DanNixon/ethernet-hexpansion/README.md

# Ethernet Hexpansion

W5500 based Ethernet and PoE hexpansion for the [Tildagon](https://tildagon.badge.emfcamp.org/) badge.

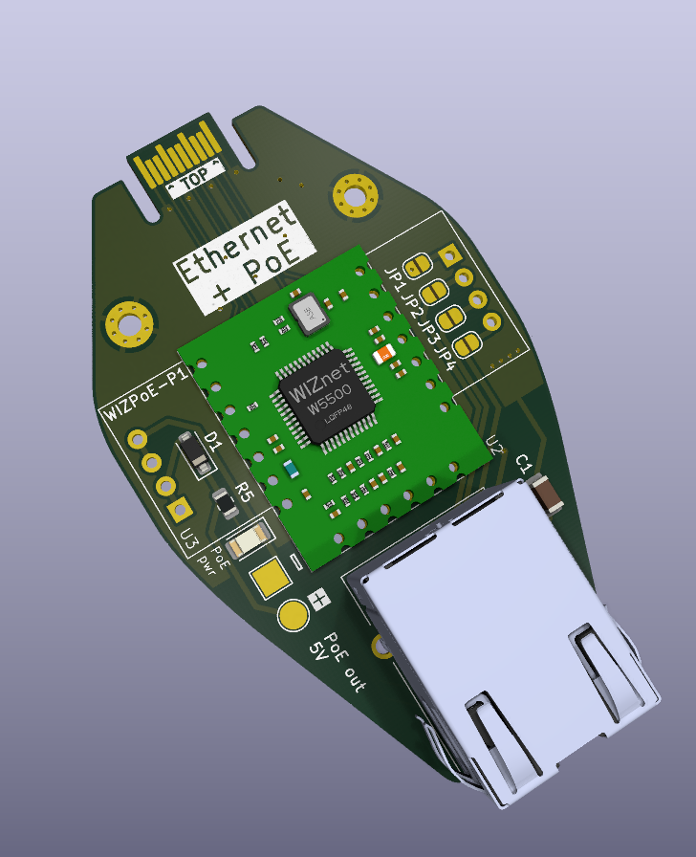
[picture p1: docs/render-front.png]
Render of PCB front
