DanNixon/ethernet-hexpansion/docs/pins.md

# Pinout

|Function|Pin |
|---|----|
|MOSI |HS 3|
|MISO |HS 4|
|SCK |HS 2|
|CS |LS 2|
|Int. |HS 1|
|Reset |LS 1|
