DanNixon/ethernet-hexpansion/docs/render-back.png

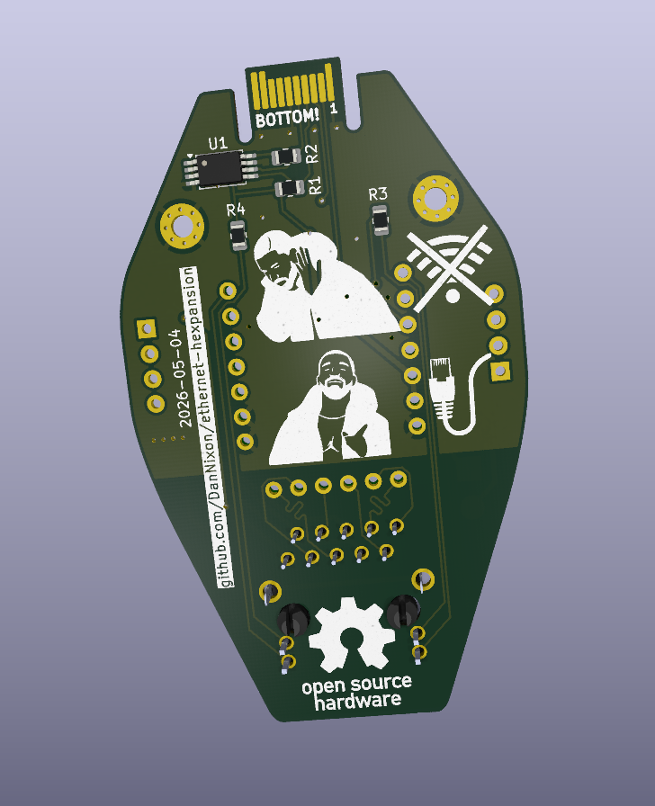
docs/render-back.png
