DanNixon/ethernet-hexpansion/pcb/drake.png

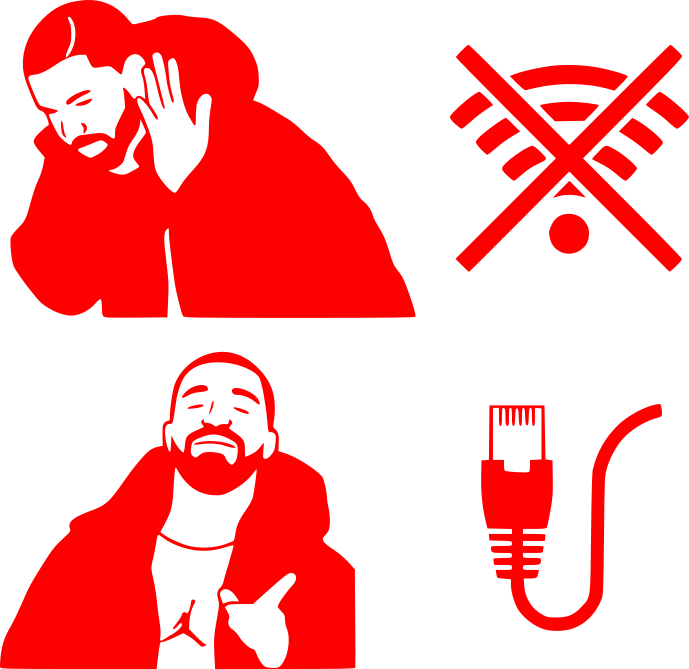
pcb/drake.png
