DanNixon/ethernet-hexpansion/pcb/hexpansion.kicad_pcb

## KiCad design pcb/hexpansion.kicad_pcb (2026-05-15)

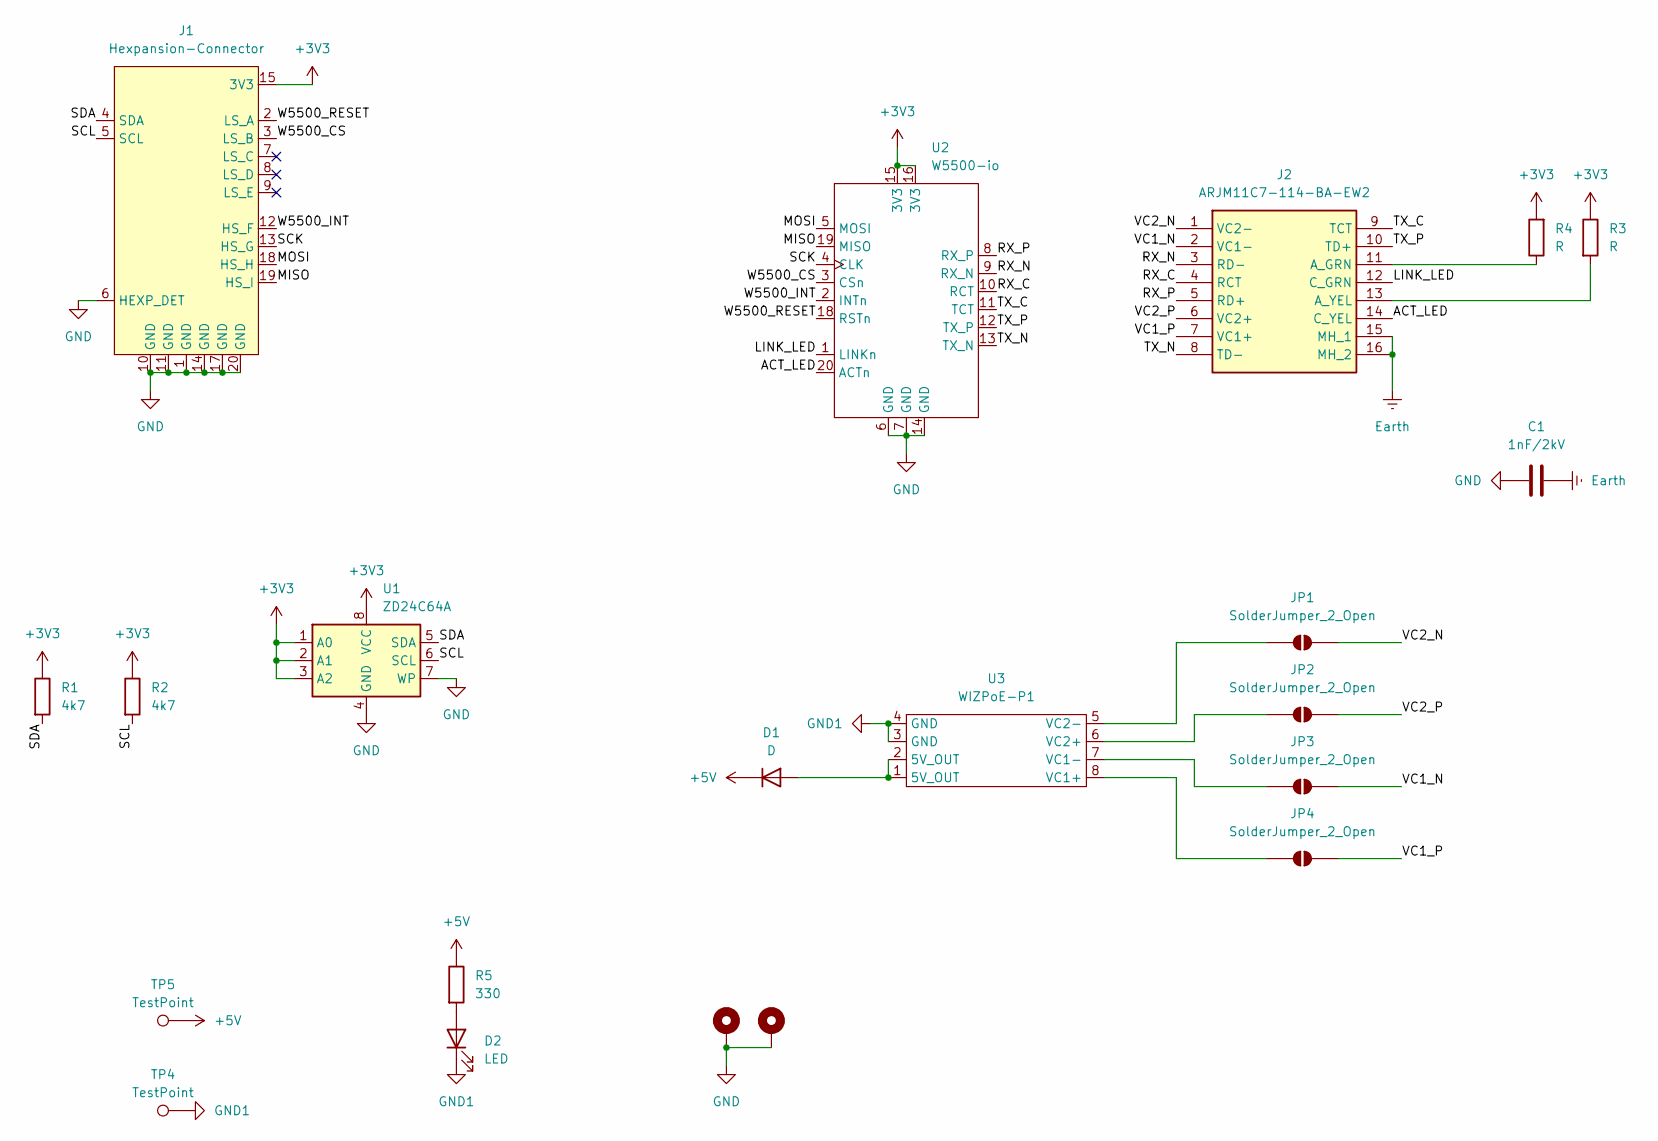
[picture p5: schematic hexpansion.kicad_sch]

Parts:
C1: 1nF/2kV; C_1206_3216Metric
D1: D; D_SOD-123
D2: LED; LED_1206_3216Metric
H1, H2: MountingHole_Pad; MountingHole_2.2mm_M2_Pad_Via
J1: Hexpansion-Connector; hexpansion-edge-connector
J2: ARJM11C7-114-BA-EW2; ARJM11C7114BAEW2; Mouser Part Number 815-RJM11C7114BAEW2
JP1, JP2, JP3, JP4: SolderJumper_2_Open; SolderJumper-2_P1.3mm_Open_RoundedPad1.0x1.5mm
R1, R2: 4k7; R_0805_2012Metric; LCSC C3017854
R3, R4: R; R_0805_2012Metric
R5: 330; R_0805_2012Metric
TP4: TestPoint; TestPoint_Pad_2.5x2.5mm
TP5: TestPoint; TestPoint_Pad_D2.5mm
U1: ZD24C64A; TSSOP-8_4.4x3mm_P0.65mm; LCSC C2875852
U2: W5500-io
U3: WIZPoE-P1

Connections:
+3V3: J1.15 (3V3), J1.16 (3V3), R1.1, R2.1, R3.1, R4.2, U1.1 (A0), U1.2 (A1), U1.3 (A2), U1.8 (VCC), U2.15 (3V3), U2.16 (3V3)
+5V: D1.1 (K), R5.1, TP5.1 (1_1)
/ACT_LED: J2.14 (C_YEL), U2.20 (ACTn)
/LINK_LED: J2.12 (C_GRN), U2.1 (LINKn)
/MISO: J1.19 (HS_I), U2.19 (MISO)
/MOSI: J1.18 (HS_H), U2.5 (MOSI)
/RX_C: J2.4 (RCT), U2.10 (RCT)
/RX_N: J2.3 (RD-), U2.9 (RX_N)
/RX_P: J2.5 (RD+), U2.8 (RX_P)
/SCK: J1.13 (HS_G), U2.4 (CLK)
/SCL: J1.5 (SCL), R2.2, U1.6 (SCL)
/SDA: J1.4 (SDA), R1.2, U1.5 (SDA)
/TX_C: J2.9 (TCT), U2.11 (TCT)
/TX_N: J2.8 (TD-), U2.13 (TX_N)
/TX_P: J2.10 (TD+), U2.12 (TX_P)
/VC1_N: J2.2 (VC1-), JP3.2 (B)
/VC1_P: J2.7 (VC1+), JP4.2 (B)
/VC2_N: J2.1 (VC2-), JP1.2 (B)
/VC2_P: J2.6 (VC2+), JP2.2 (B)
/W5500_CS: J1.3 (LS_B), U2.3 (CSn)
/W5500_INT: J1.12 (HS_F), U2.2 (INTn)
/W5500_RESET: J1.2 (LS_A), U2.18 (RSTn)
Earth: C1.1, J2.15 (MH_1), J2.16 (MH_2)
GND: C1.2, H1.1 (1_1), H2.1 (1_1), J1.1 (GND), J1.6 (HEXP_DET), J1.10 (GND), J1.11 (GND), J1.14 (GND), J1.17 (GND), J1.20 (GND), U1.4 (GND), U1.7 (WP), U2.6 (GND), U2.7 (GND), U2.14 (GND)
GND1: D2.1 (K), TP4.1 (1_1), U3.3 (GND), U3.4 (GND)
unnamed: D1.2 (A), U3.1 (5V_OUT), U3.2 (5V_OUT)
unnamed: D2.2 (A), R5.2
unnamed: J2.11 (A_GRN), R4.1
unnamed: J2.13 (A_YEL), R3.2
unnamed: JP1.1 (A), U3.5 (VC2-)
unnamed: JP2.1 (A), U3.6 (VC2+)
unnamed: JP3.1 (A), U3.7 (VC1-)
unnamed: JP4.1 (A), U3.8 (VC1+)

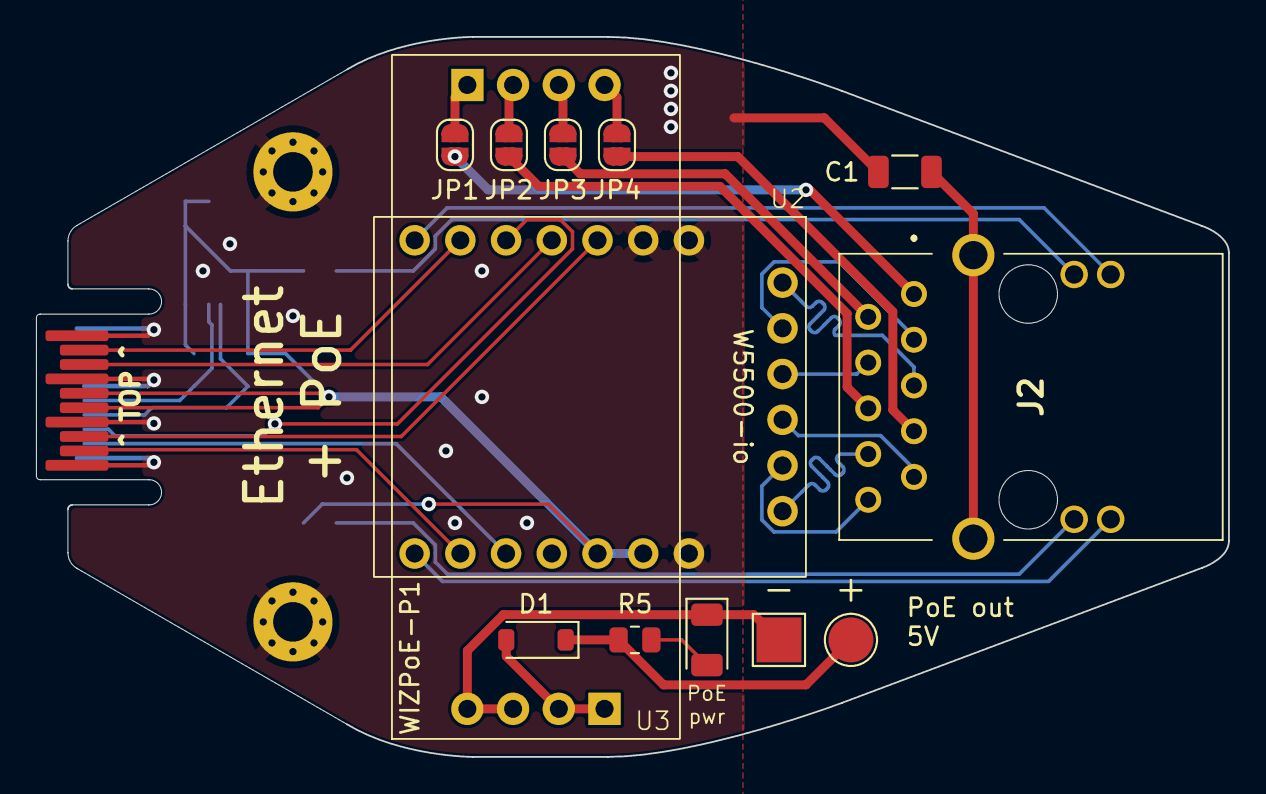
[picture p6: board hexpansion.kicad_pcb from above]

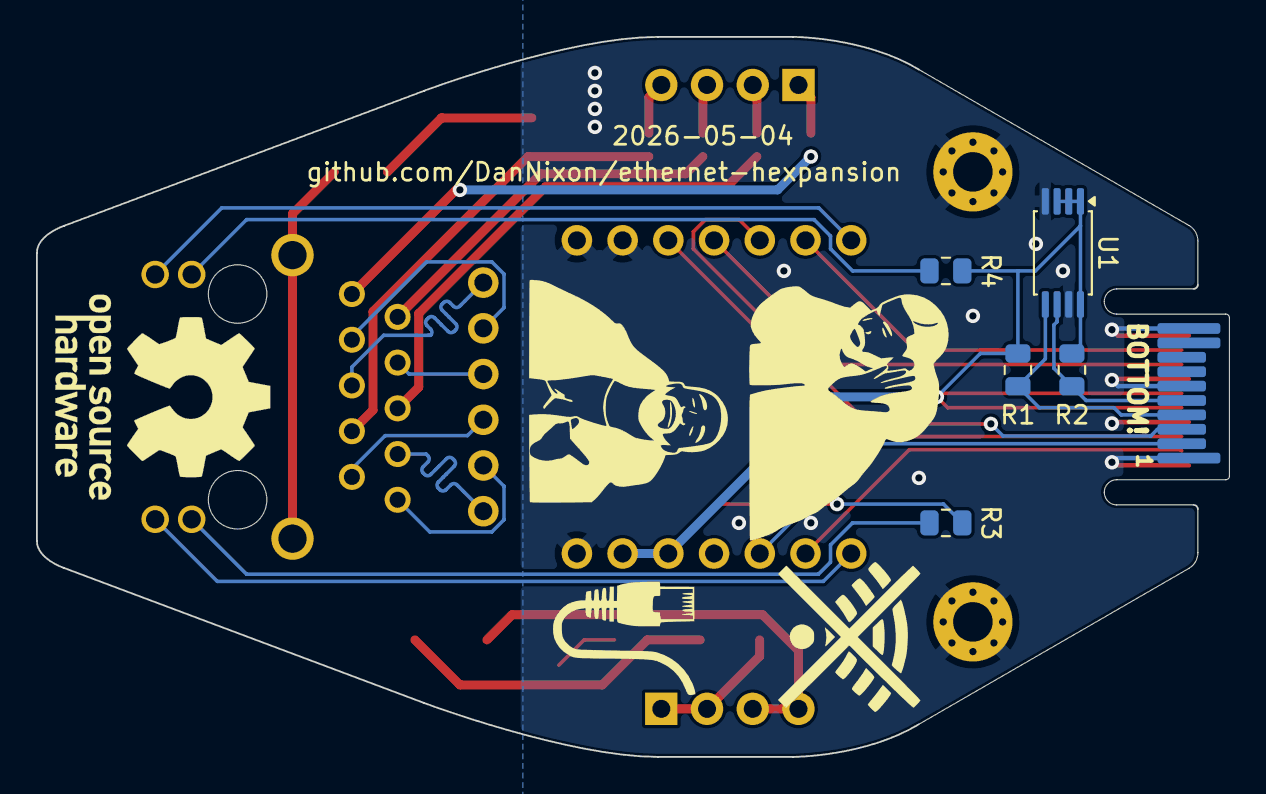
[picture p7: board hexpansion.kicad_pcb from below]

Board: 2 copper layers, 66.2 x 40.0 mm, 21 parts (5 on the bottom side), 33 nets.
