DanNixon/ethernet-hexpansion/demo-firmware/src/main.rs

#![no_std]
#![no_main]
#![deny(
    clippy::mem_forget,
    reason = "mem::forget is generally not safe to do with esp_hal types, especially those \
    holding buffers for the duration of a data transfer."
)]

mod display;
mod fake_pin;
mod leds;
mod wall_time;

use defmt::info;
use embassy_executor::Spawner;
use embassy_net::StackResources;
use embassy_net_wiznet::{Device, Runner, State, chip::W5500};
use embassy_time::Timer;
use embedded_hal_bus::spi::ExclusiveDevice;
use fake_pin::FakePin;
use panic_rtt_target as _;
use static_cell::StaticCell;
use tildagon::{
    embedded_aw9523::{PinConfiguration, async_traits::digital::OutputPin},
    esp_hal::{
        self,
        clock::CpuClock,
        dma::{DmaRxBuf, DmaTxBuf},
        dma_buffers,
        gpio::Input,
        rmt::Rmt,
        rng::Rng,
        spi::{
            Mode,
            master::{Config, Spi, SpiDmaBus},
        },
        time::Rate,
        timer::timg::TimerGroup,
    },
    hexpansions::{HexpansionSlot, HexpansionSlotControl},
    i2c::{SharedI2cBus, SharedI2cDevice, SystemI2cBus},
    led_power::OnboardLedPower,
    pins::PinControl,
    resources::*,
    usb::{UsbPort, UsbSwitch},
};

extern crate alloc;

// This creates a default app-descriptor required by the esp-idf bootloader.
// For more information see: <https://docs.espressif.com/projects/esp-idf/en/stable/esp32/api-reference/system/app_image_format.html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>
esp_bootloader_esp_idf::esp_app_desc!();

#[esp_rtos::main]
async fn main(spawner: Spawner) {
    rtt_target::rtt_init_defmt!();

    let config = tildagon::esp_hal::Config::default().with_cpu_clock(CpuClock::max());
    let p = tildagon::esp_hal::init(config);
    let r = tildagon::split_resources!(p);

    esp_alloc::heap_allocator!(size: 64 * 1024);
    // COEX needs more RAM - so we've added some more
    esp_alloc::heap_allocator!(#[unsafe(link_section = ".dram2_uninit")] size: 64 * 1024);

    let timg0 = TimerGroup::new(p.TIMG0);
    esp_rtos::start(timg0.timer0);

    static I2C_BUS: StaticCell<SharedI2cBus<tildagon::i2c::I2c>> = StaticCell::new();
    let (bus, _reset) = tildagon::i2c::i2c_bus(r.i2c).await;
    let i2c_bus = I2C_BUS.init(bus);

    static I2C_SYSTEM: StaticCell<SharedI2cBus<tildagon::i2c::SystemI2cBus>> = StaticCell::new();
    let i2c_system = I2C_SYSTEM.init(tildagon::i2c::system_i2c_bus(i2c_bus));

    let mut pin_control = PinControl::new(i2c_system).await.unwrap();
    let pins = pin_control.pins();

    let mut usb_sw = UsbSwitch::new(pins.usb);
    usb_sw.set(UsbPort::In).await.unwrap();

    let mut hex_slots = HexpansionSlotControl::new(pins.hexpansion_detect)
        .await
        .unwrap();

    let rmt: Rmt<'_, esp_hal::Blocking> = Rmt::new(p.RMT, Rate::from_mhz(80)).unwrap();

    let mut led_power = OnboardLedPower::new(pins.led);
    led_power.set(true).await.unwrap();

    spawner.must_spawn(leds::task(r.led, rmt.channel0));

    let hex_a_fast = r.hexpansion_a;
    let hex_a_slow = pins.hexpansion_a;

    hex_slots
        .set_enabled(HexpansionSlot::A, true)
        .await
        .unwrap();

    let dma_channel = p.DMA_CH1;

    let (rx_buffer, rx_descriptors, tx_buffer, tx_descriptors) = dma_buffers!(32000);
    let dma_rx_buf = DmaRxBuf::new(rx_descriptors, rx_buffer).unwrap();
    let dma_tx_buf = DmaTxBuf::new(tx_descriptors, tx_buffer).unwrap();

    let cs = hex_a_slow.ls_2.try_into_output().await.unwrap();

    let spi = Spi::new(
        p.SPI3,
        Config::default()
            .with_frequency(Rate::from_mhz(10))
            .with_mode(Mode::_0),
    )
    .unwrap()
    .with_sck(hex_a_fast.hs_2)
    .with_mosi(hex_a_fast.hs_3)
    .with_miso(hex_a_fast.hs_4)
    .with_dma(dma_channel)
    .with_buffers(dma_rx_buf, dma_tx_buf)
    .into_async();

    let w5500_int = Input::new(hex_a_fast.hs_1, Default::default());

    let mut w5500_reset = hex_a_slow.ls_1.try_into_output().await.unwrap();
    w5500_reset.set_low().await.unwrap();
    Timer::after_millis(100).await;
    w5500_reset.set_high().await.unwrap();
    Timer::after_millis(100).await;

    let w5500_spi_dev = ExclusiveDevice::new(spi, cs, embassy_time::Delay).unwrap();

    let mac_addr = [0x02, 0x00, 0x00, 0x00, 0x00, 0x00];
    static STATE: StaticCell<State<8, 8>> = StaticCell::new();
    let state = STATE.init(State::<8, 8>::new());
    let (device, runner) = embassy_net_wiznet::new(
        mac_addr,
        state,
        w5500_spi_dev,
        w5500_int,
        FakePin::default(),
    )
    .await
    .unwrap();
    spawner.spawn(ethernet_task(runner)).unwrap();

    let rng = Rng::new();
    let seed = rng.random() as u64;

    static RESOURCES: StaticCell<StackResources<3>> = StaticCell::new();
    let (stack, runner) = embassy_net::new(
        device,
        embassy_net::Config::dhcpv4(Default::default()),
        RESOURCES.init(StackResources::new()),
        seed,
    );
    spawner.spawn(net_task(runner)).unwrap();

    spawner.must_spawn(display::task(r.top_board, p.SPI2, p.DMA_CH0, stack));

    info!("Waiting for DHCP...");
    stack.wait_link_up().await;
    stack.wait_config_up().await;
    let cfg = stack.config_v4().unwrap();
    let local_addr = cfg.address.address();
    info!("IP address: {:?}", local_addr);

    spawner.spawn(wall_time::ntp_task(stack)).unwrap();
}

type EthernetSpi = ExclusiveDevice<
    SpiDmaBus<'static, tildagon::esp_hal::Async>,
    tildagon::embedded_aw9523::Output<SharedI2cDevice<SystemI2cBus>>,
    embassy_time::Delay,
>;

#[embassy_executor::task]
async fn ethernet_task(runner: Runner<'static, W5500, EthernetSpi, Input<'static>, FakePin>) -> ! {
    runner.run().await
}

#[embassy_executor::task]
async fn net_task(mut runner: embassy_net::Runner<'static, Device<'static>>) -> ! {
    runner.run().await
}
